meskkkk/esp32-humanoid-kicker/marketing poster.jpeg

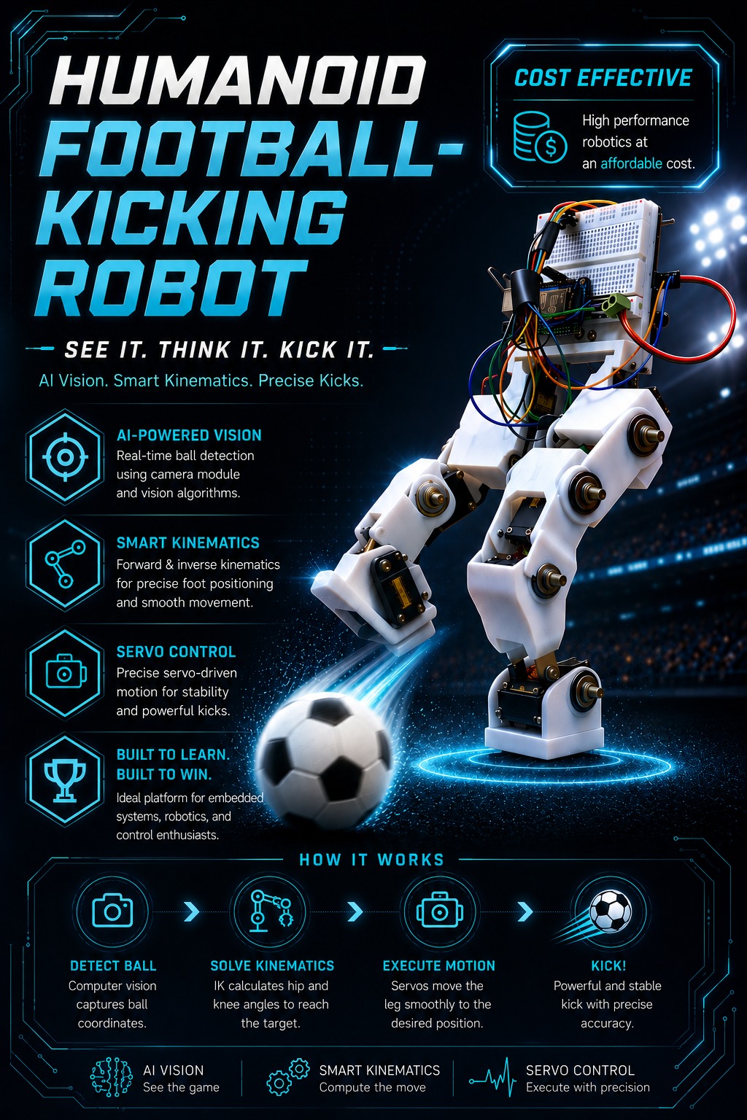
marketing poster.jpeg
