meskkkk/esp32-humanoid-kicker/README.md

# esp32-humanoid-kicker

Humanoid robot project image

# Embedded Systems Project

This project brings together computer vision, embedded control, and motion simulation for a humanoid robot kicking system.
This workspace documents a humanoid robot kicking project built around computer vision, embedded control, telemetry, and motion simulation. The goal is to detect a ball, estimate the robot's motion, drive the servo-based leg mechanism, and visualize the resulting behavior through dashboards and simulation tools.

The project is organized so each stage of the workflow can be developed and reviewed separately:

- The YOLO folder contains the ball-detection pipeline and calibration data used for vision-based targeting.
- The humanoid-robot-kinematics folder contains the Arduino sketch that controls the robot hardware.
- The dashboard folder contains files for telemetry display, experiment playback, and HTML-based visualization.
- The MATLAB simulation folder contains forward kinematics, inverse kinematics, servo dynamics, and kick-animation models that help validate the motion before or alongside hardware testing.
- The top-level documents and images provide the physical design references, reports, presentation assets, and project visuals.

## Project Overview

This project combines three main parts:

1. Vision and detection: a YOLO-based pipeline identifies the ball and stores calibration and telemetry data.
2. Embedded motion control: the robot kinematics code drives the humanoid mechanism used for kicking.
3. Simulation and reporting: MATLAB, Simulink, dashboard, and media files document the behavior of the system and support analysis.

Together, these files show the full path from detection to actuation to visualization, which makes the workspace useful both for development and for presenting the system design.

## File Guide                 

### Vision And Detection

The [ball detection YOLO/](ball%20detection%20YOLO/) folder contains the main vision pipeline used to identify the ball and prepare data for the robot control flow.

| File | Purpose |
| --- | --- |
| [yolo.py](ball%20detection%20YOLO/yolo.py) | Main YOLO detection script for tracking the ball. |
| [calibration.py](ball%20detection%20YOLO/calibration.py) | Calibration helper for the vision setup. |
| [calibration.json](ball%20detection%20YOLO/calibration.json) | Stored calibration values. |
| [ball_telemetry.json](ball%20detection%20YOLO/ball_telemetry.json) | Saved telemetry or detection output. |
| [yolov8s.onnx](ball%20detection%20YOLO/yolov8s.onnx) | ONNX export for inference. |
| [yolov8s.pt](ball%20detection%20YOLO/yolov8s.pt) | YOLOv8 model weights. |

### Robot Control

The [humanoid-robot-kinematics/](humanoid-robot-kinematics/) folder holds the embedded code that controls the robot hardware.

| File | Purpose |
| --- | --- |
| [humanoid-robot-kinematics.ino](humanoid-robot-kinematics/humanoid-robot-kinematics.ino) | Arduino sketch for robot kinematics and motion control. |

### Dashboard And Telemetry

The [dashboard/](dashboard/) folder contains the files used to display telemetry and review results in a simple browser-based interface.

| File | Purpose |
| --- | --- |
| [dashboard.html](dashboard/dashboard.html) | Main dashboard interface. |
| [telemetry_data.js](dashboard/telemetry_data.js) | JavaScript telemetry source for the dashboard. |
| [telemetry.json](dashboard/telemetry.json) | Telemetry dataset used for visualization. |
| [kick_with_telemetry.m](dashboard/kick_with_telemetry.m) | MATLAB bridge for kick behavior and telemetry. |
| [run dashboard.txt](dashboard/run%20dashboard.txt) | Notes for running the dashboard. |
| [dashboard demo.mp4](dashboard/dashboard%20demo.mp4) | Demo recording of the dashboard. |

### MATLAB Simulation

The [MATLAB simulation/](MATLAB%20simulation/) folder contains the modeling work used to validate the robot leg motion before or alongside hardware testing.

#### 2D Kick Animation

| File | Purpose |
| --- | --- |
| [leg_kick_animation.m](MATLAB%20simulation/2D%20Kick%20Animation/leg_kick_animation.m) | 2D kick animation script. |
| [kick_animation.mp4](MATLAB%20simulation/2D%20Kick%20Animation/kick_animation.mp4) | Output video of the 2D animation. |

#### 3D Humanoid Simulation

| File | Purpose |
| --- | --- |
| [humanoid_3D_kick.m](MATLAB%20simulation/3D%20Humanoid%20Simulation/humanoid_3D_kick.m) | 3D humanoid kick simulation. |
| [humanoid_3D_kick.mp4](MATLAB%20simulation/3D%20Humanoid%20Simulation/humanoid_3D_kick.mp4) | Output video of the 3D simulation. |

#### Forward Kinematics

| File | Purpose |
| --- | --- |
| [leg_FK.m](MATLAB%20simulation/Forward%20Kinematics/leg_FK.m) | Forward kinematics model for the robot leg. |

#### Inverse Kinematics

| File | Purpose |
| --- | --- |
| [leg_IK.m](MATLAB%20simulation/Inverse%20Kinematics/leg_IK.m) | Inverse kinematics solver for the robot leg. |

#### Simulink Servo Dynamics

| File | Purpose |
| --- | --- |
| [servo_simulink.slx](MATLAB%20simulation/Simulink%20Servo%20Dynamics/servo_simulink.slx) | Simulink model for servo response and dynamics. |
| [servo scope.png](MATLAB%20simulation/Simulink%20Servo%20Dynamics/servo%20scope.png) | Scope capture from the servo model. |

## Project Assets

These files support documentation, design review, and presentation of the project.

| File | Purpose |
| --- | --- |
| [circuit diagram.png](circuit%20diagram.png) | Electrical wiring reference. |
| [schematic diagram.png](schematic%20diagram.png) | Circuit schematic for the embedded system. |
| [marketing poster.jpeg](marketing%20poster.jpeg) | Poster-style project summary image. |
| [presentation.pdf](presentation.pdf) | Presentation deck for the project. |
| [report.pdf](report.pdf) | Full project report. |
| [inverse kinematics (theoritical).pdf](<inverse%20kinematics%20(theoritical).pdf>) | Theory reference for the kinematics model. |

## Suggested Reading Order

If you are viewing the repository for the first time, start with the portfolio overview above, then review the vision folder, the robot control sketch, and the simulation folders. Finish with the dashboard and project assets to see how the technical work is presented and documented.
