meskkkk/esp32-humanoid-kicker/inverse kinematics (theoritical).pdf

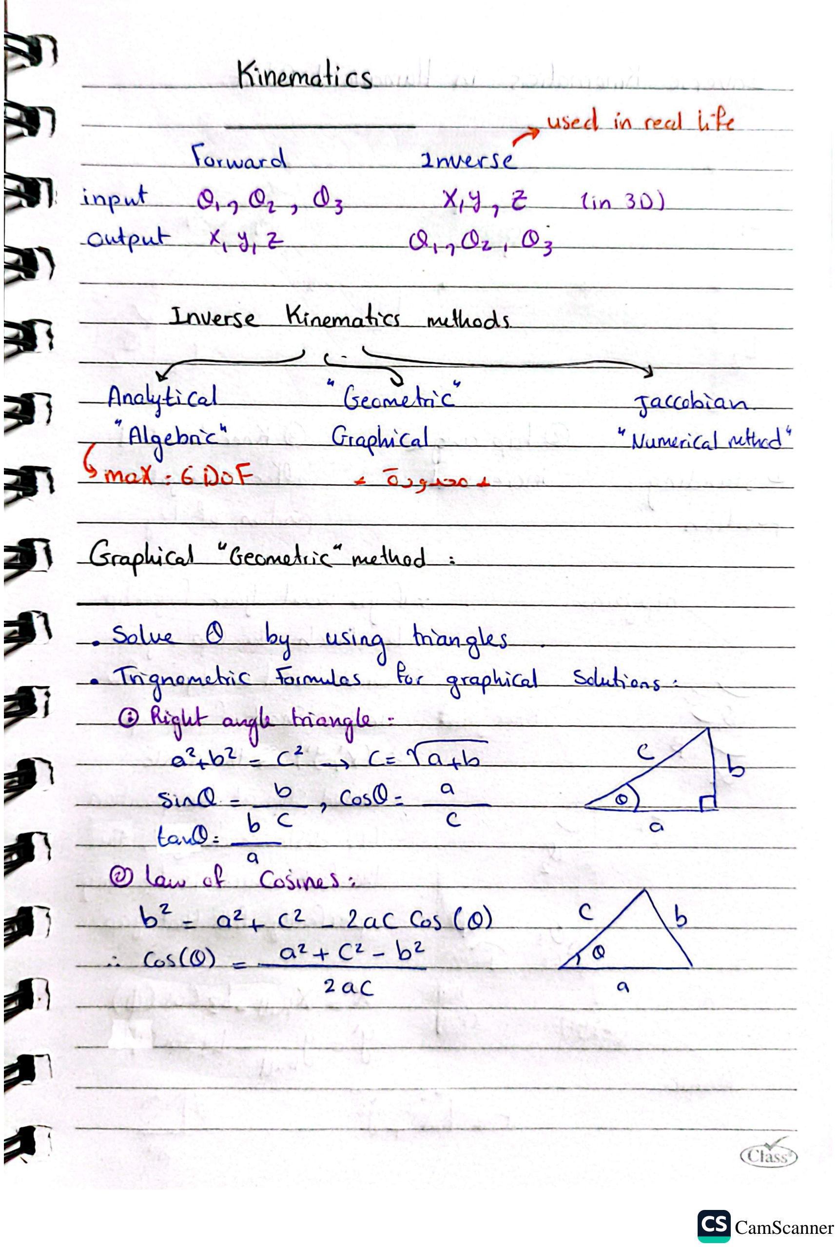
[picture p5: page 1]

CamScanner (https://v3.camscanner.com/user/download)

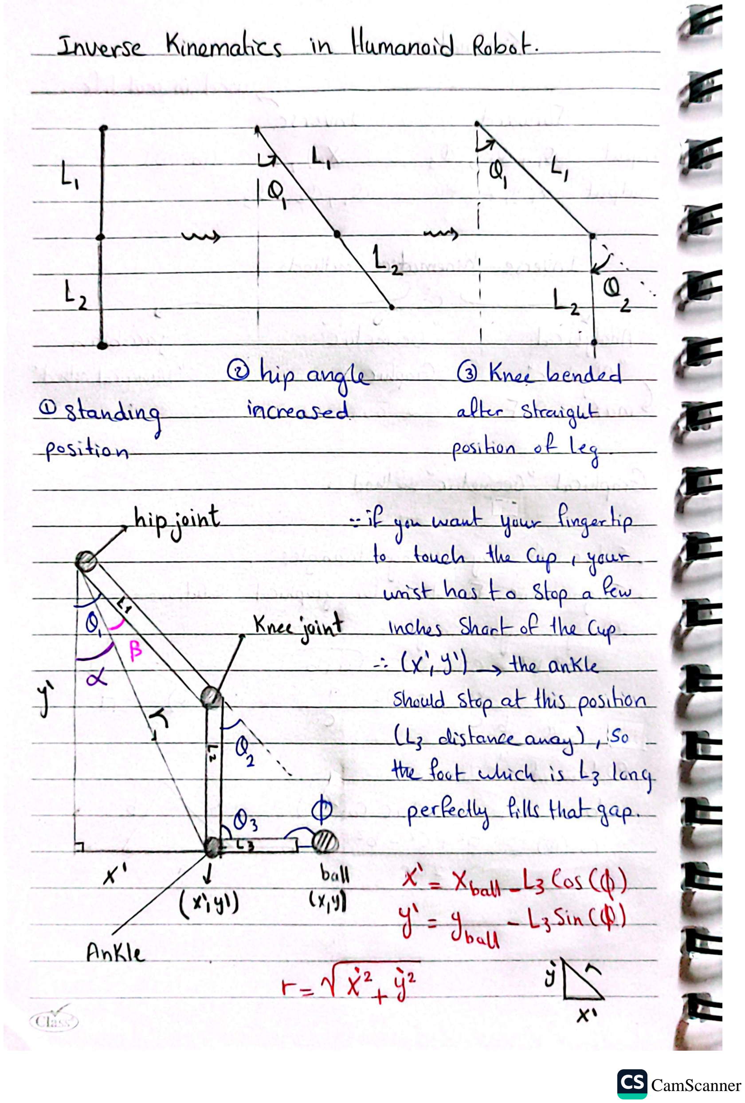
[picture p6: page 2]
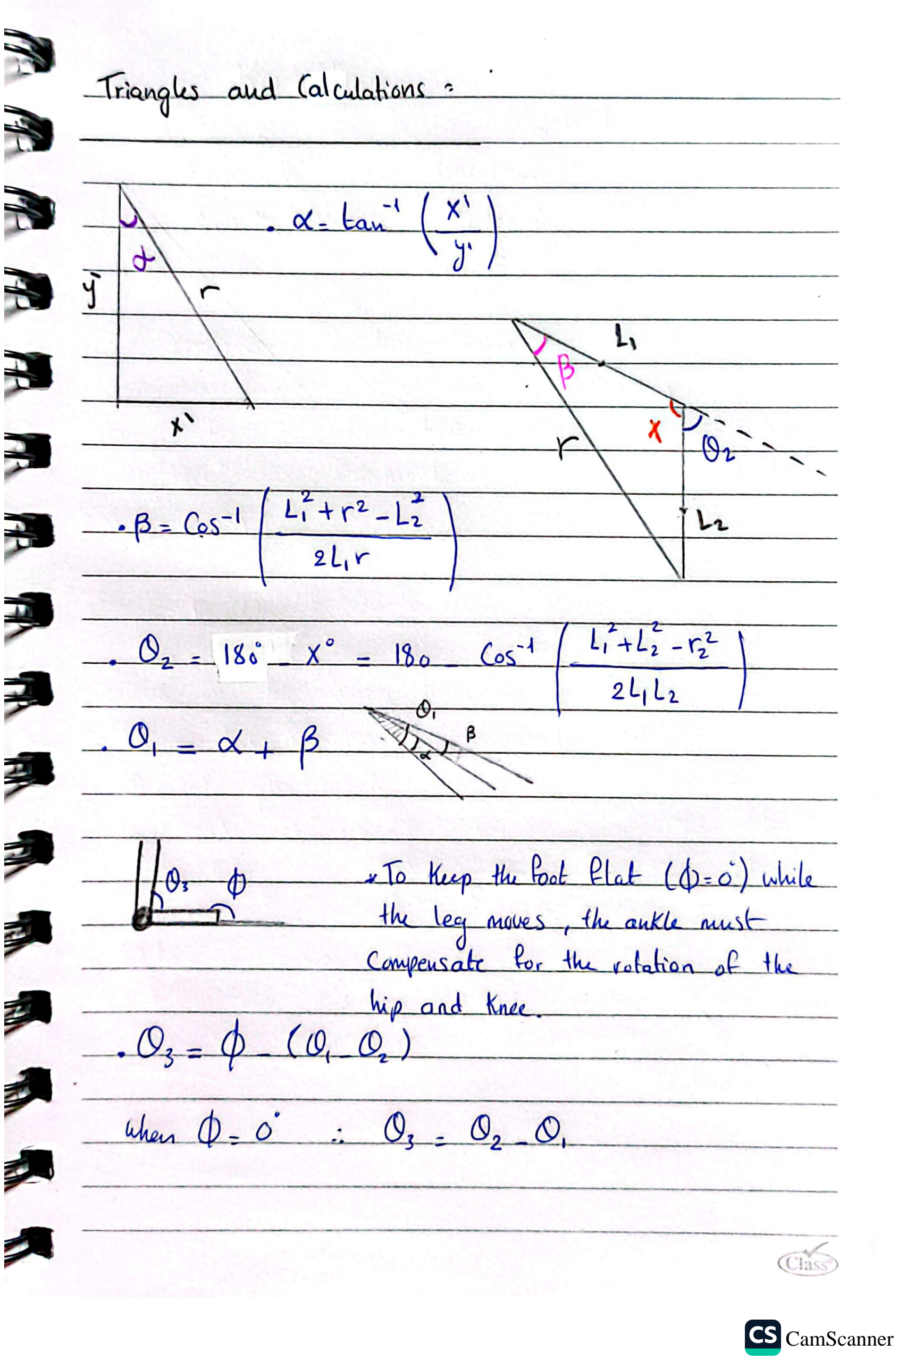
[picture p7: page 3]
