meskkkk/esp32-humanoid-kicker/circuit diagram.png

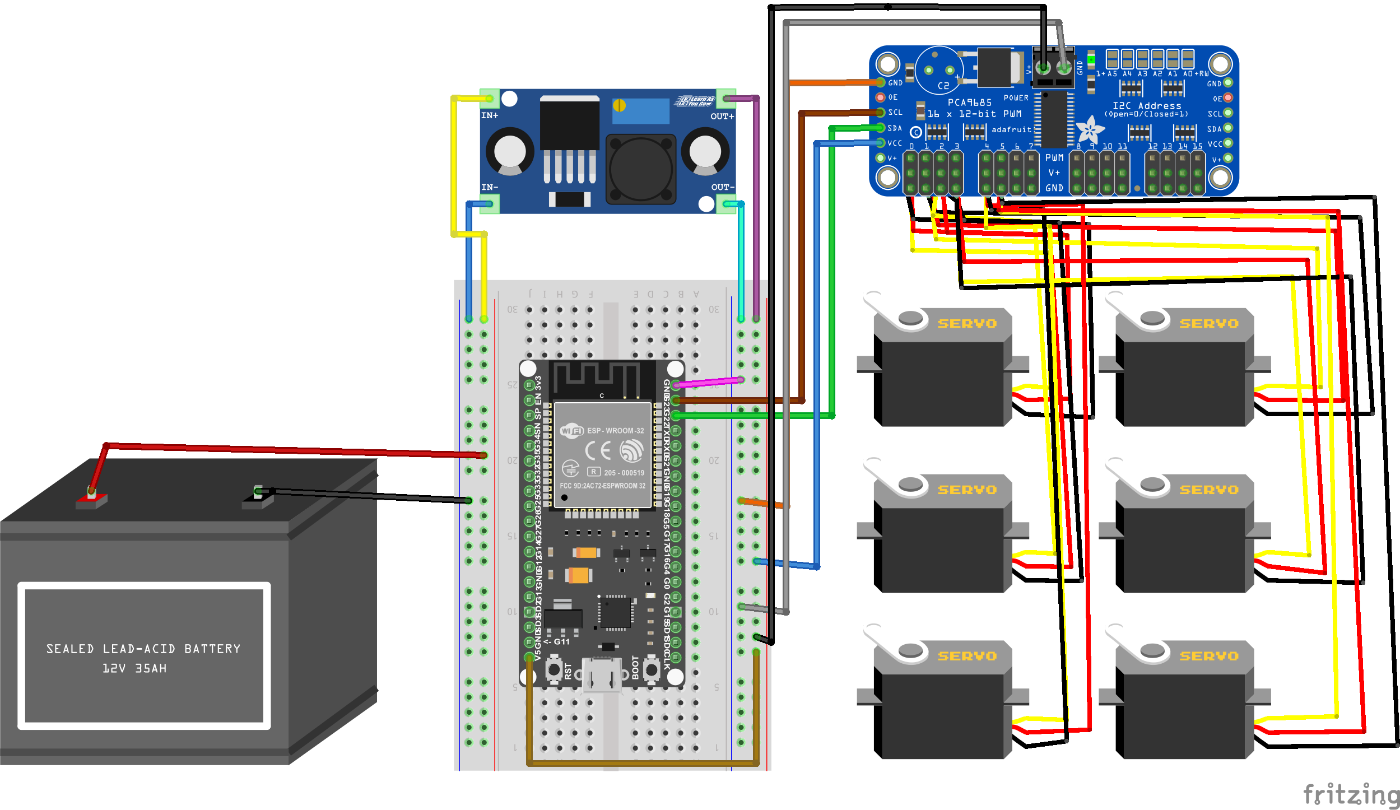
circuit diagram.png
