meskkkk/esp32-humanoid-kicker/MATLAB simulation/Simulink Servo Dynamics/servo scope.png

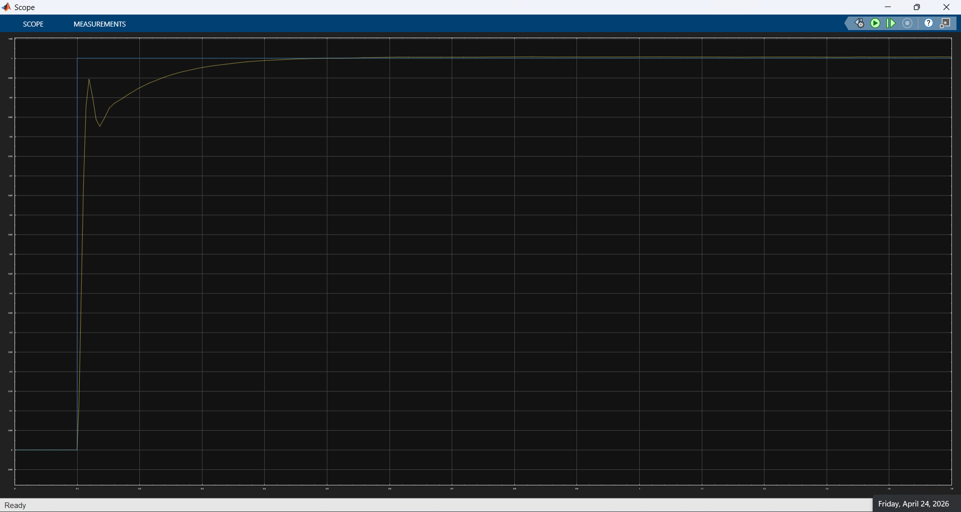
MATLAB simulation/Simulink Servo Dynamics/servo scope.png
