meskkkk/esp32-humanoid-kicker/schematic diagram.png

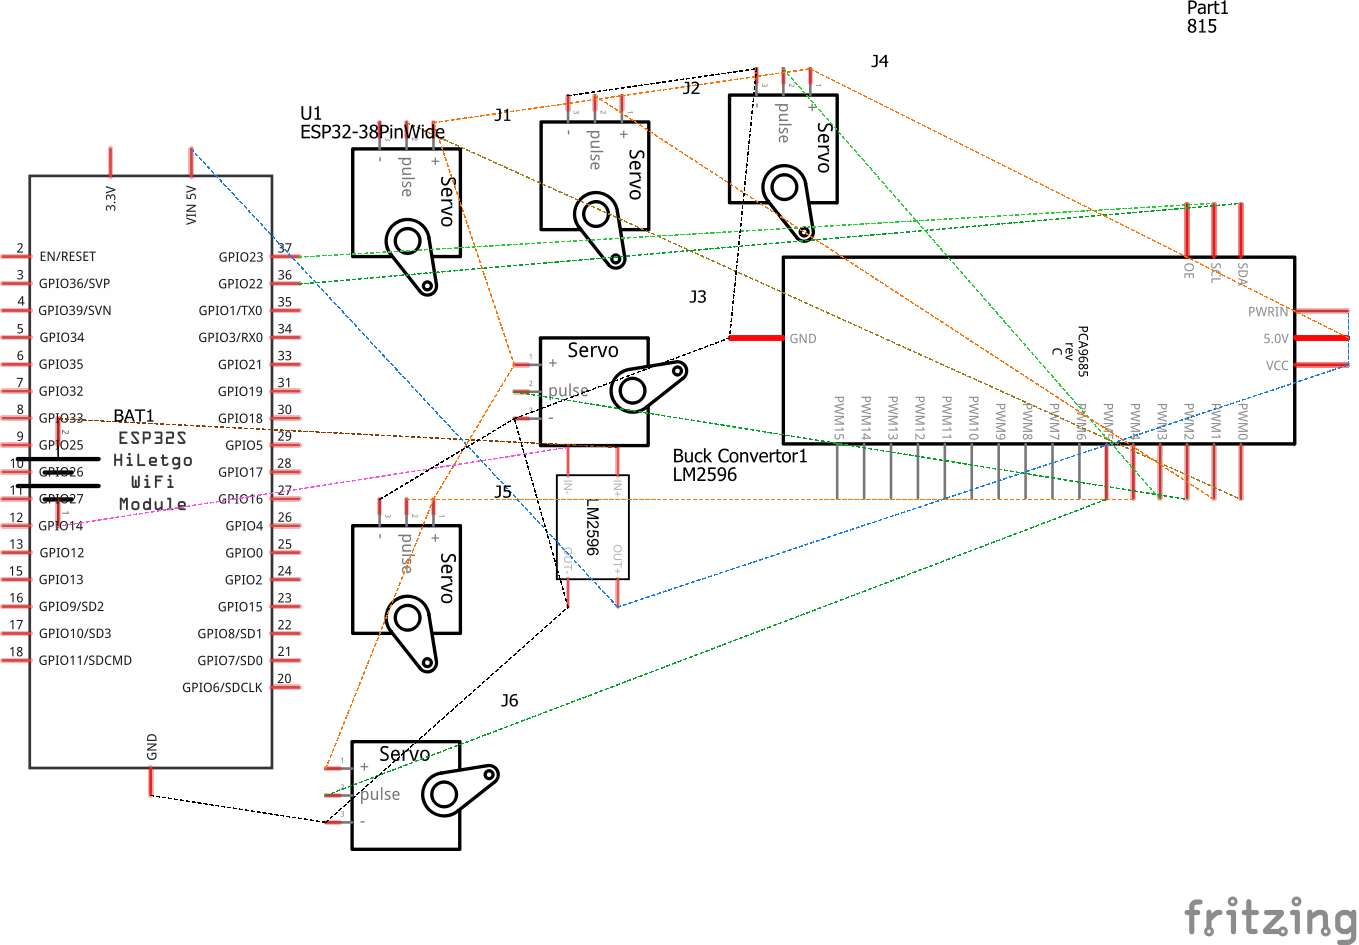
schematic diagram.png
